rotzila/music-muscle/box/top.stl

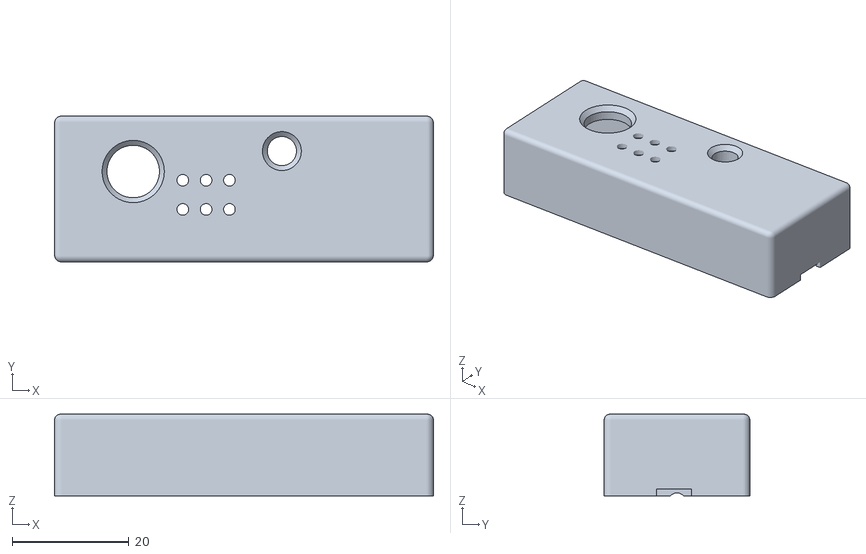
[picture p6: CAD file, 2019-08-19]
box/top.stl
65.0 x 25.0 x 14.0
