rotzila/music-muscle/box/button.stl

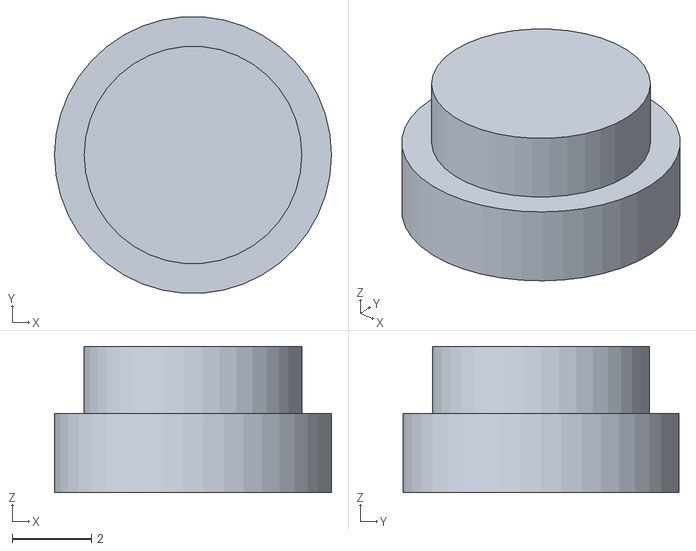
[picture p7: CAD file, 2019-08-19]
box/button.stl
7.00 x 6.98 x 3.70
