rotzila/music-muscle/box/bottom.stl

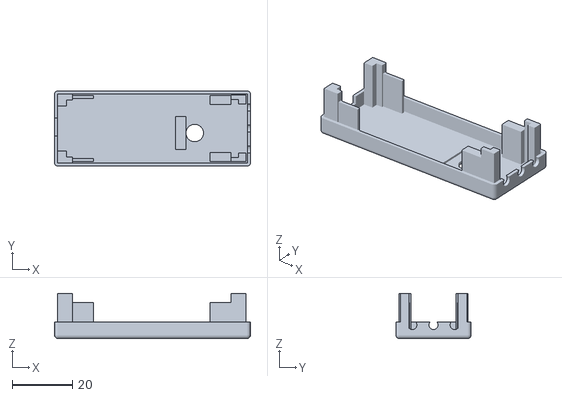
[picture p8: CAD file, 2019-08-19]
box/bottom.stl
65.0 x 25.0 x 15.0
