rotzila/music-muscle/(list of files, cad)

Other CAD files:
box/bottom.CATPart
box/button.CATPart
box/top.CATPart
